DekkrixX/Data-Monitoring-Football-Fan/README.md

# Data-Monitoring-Football-Fan

Installation des dépendances `make install`.

Construction des images Docker `make build`.

Flash des cartes ESP32 utilisez le script flash.sh `bash Scripts/flash.sh <cible>`.

Lancement des serveurs `make run`.

---











---

## Description du projet

Le projet de monitoring pour supporters de football est la réalisation d'une collaboration entre le Lab-STICC (le centre de recherche de Lorient) et le FCL (le Football Club de Lorient). L'objectif de ce projet est de développer une solution IoT performante, économique et à gestion locale des données pour analyser les données des supporters pendant les matchs de football. Les données collectées seront utilisées pour réaliser une vidéo promotionnelle valorisant le club, la ville et le laboratoire de recherche de Lorient. Le projet est réalisé par des étudiants du Master Systèmes Embarqués - Systèmes Intégrés à Lorient sous la supervision de deux ingénieurs du Lab-STICC.

## Fonctionnalitées du projet

- Collect de la fréquence cardiaque
- Collect de données de mouvement
- Collect de données acoustique
- Collect d'information système
- Tracking d'objet
- Affichage des statistiques des données des utilisateurs
- Affichage des statistiques des données des tribunes du stade
- Gestion des évènements du match en direct
