DekkrixX/Data-Monitoring-Football-Fan/Resources/Images/schema_noeud_LoRa.png

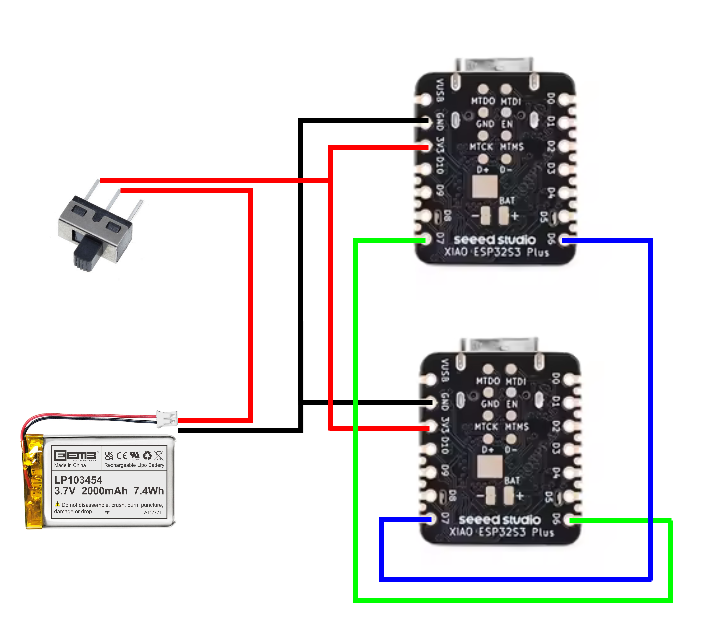
Resources/Images/schema_noeud_LoRa.png
