DekkrixX/Data-Monitoring-Football-Fan/Documentation/test.md

# Tests

# Lancer les tests de simulations

Pour lancer les tests de simulations il faut taper `make test` à la racine du projet. Cela va lancer un script python en tâche de fond, qui envoi des données toutes les secondes sur le brocker MQTT.

# Tests de portée LoRa en ligne de vue

Test avec le firmware Meshtastic et le paramètre LONG_FAST distance de 800 mètres sans perte de paquets.
