DekkrixX/Data-Monitoring-Football-Fan/(commit log)

2026-03-02 Réécriture du code (optimisation, extensibilité, centralisation des paramètres) + documentation complète
2026-03-03 Gestion du duty cycle + bufferisation des données
2026-03-03 Gestion de message d'information système
2026-03-03 Correction duty cycle + info capteur
    [PolarH10.cpp, setting.hpp]
2026-03-03 Fix bug buffer UART inversé
    [UARTManager.cpp, UARTManager.hpp]
2026-03-03 Ajout de la doc du commit précédant
2026-03-03 Mise à jour de la Documentation
2026-03-04 Tests de distance de portée
2026-03-05 Chiffrage des variables d'environnement
2026-03-06 Ajout d'un système de log pour le server et le device
    [partitions.csv]
2026-03-06 Ajout d'un script de chiffrement/déchiffrement
2026-04-08 Ajout des formats de données et des montages des capteurs dans la documentation
2026-04-08 Modification du système de log pour séparer les logs de debug et les logs de données
2026-04-09 Integration du capteur MinIMU-9 v6 dans les données serveur
2026-04-09 Ajout des link card de monitoring des tribunes
2026-04-10 Intégration des données du capteur MinIMU-9 v6 au serveur + visualisation
2026-04-10 Modification du format d'envoi des données du capteur MinIMU-9 v6
2026-04-10 Ajout de la prise en compte du delais d'acquisition des capteurs dans le timestamp des données
2026-04-10 Initialisation de la structure du capteur INMP441
2026-04-10 Ajout du type de données acoustique
2026-04-14 Ajout de la structure de controle via l'interface web
2026-04-14 Correction de l'installation automatique (PC vierge)
2026-04-14 Interprétation des données brutes
2026-04-14 Optimisation des envois de message via LoRa
2026-04-15 Gestion des dépendances par Docker
2026-04-15 Ajout de test de simulation des données
2026-04-16 Modification des scripts pour la compatibilité avec Docker
2026-04-16 Uniformisation du code et des commantaires
2026-04-16 Mise à jour de la doc
2026-04-17 Structure de l'interface de contrôle d'évènement + correction test complet (sans compatibilité entre les données device et server)
    [setting.hpp]
2026-04-17 Changement d'encodage du type de données qui circule via LoRa
2026-04-20 Changement de format d'envoie de données du capteur MinIMU-9 v6 (norme du vecteur accélération)
2026-04-23 Changement du visuel de l'interface et ajout de la partie contrôle d'évènements
2026-04-23 Gestion de la création d'une configuration de contrôle d'évènements
2026-04-24 Gestion des informations d'avant match et des évènements en temps réel
2026-04-24 Ajout de champs général de modification d'évènement
2026-04-27 Ajout des données capteurs dans InfluxDB
2026-04-27 Ajout des données d'évènements à la base de données PostgreSQL
2026-04-28 Ajout de la modification des informations d'évènement
2026-04-29 Gestion complète des données d'évènements
2026-04-29 Ajout de la minute de jeu dans le nom des évènements
2026-04-30 Gestion de la cohérance entre le timestamp et la minute de jeu d'un évènement
2026-04-30 Changement de l'ordre de la liste des évènements pour garder la logique chronologique
2026-05-04 Ajout de la clé GPG du labsticc + correction d'ajout et suppression de clé
2026-05-04 Fix erreur nom de fichier
2026-05-06 Modification des tests de distance + vérification de la configuration Meshtastic
2026-05-11 Modification erreur de syntaxe
2026-05-12 Ajout de MeshCore sur la partie serveur
2026-05-13 Fix problème de crash du code du capteur INMP441
2026-05-13 Ajout des adresses MAC
2026-05-13 Ajout de solution de potentiel problème
2026-05-18 Ajout de gestion de la LED de la carte + Fix bug lectrue des logs sur UART
    [main.cpp, setting.hpp]
2026-05-18 Ajout couleur LED en cas d'erreur et inclusion du code des capteurs en fonction du capteur configuré
2026-05-18 Mise à jour des schémas
2026-05-18 Fix potentiel fuite mémoire si plusieurs instance de class
    [MinIMU-9_v6.cpp, PolarH10.cpp, UARTManager.cpp, main.cpp, setting.hpp]
2026-05-18 Modification LEDManager pour faire clignoter la LED
2026-05-19 Ajout page de log d'information système des capteurs
2026-05-19 Formatage des pages web (page fixe sans scroll)
2026-05-19 Changement nombre de logger
2026-05-19 Modification du test de distance
    [config.txt, partitions.csv]
2026-05-19 Ajout de la suppression des conteneurs de test
2026-05-19 Suppression des images docker au clear
2026-05-22 Ajout de la gestion de tracker coté serveur et client
2026-05-22 Ajout de test de simulation pour les trackers
2026-05-26 Ajout du chemin de tracer des trackers
2026-05-26 Modification test tracking, ajout d'un léger dépassement de zone
2026-05-26 Ajout de l'utilisation des cartes UWB Qorvo
2026-05-26 Ajout de la procédure de flash des cartes UWB
2026-05-26 Ajout de la description de la carte UWB
2026-05-27 Ajout de la récupération des communications des cartes UWB et calcul de la position
2026-05-29 Correction orthographe
    [config.txt]
2026-06-01 Modification bug affichage + ajout d'envoie de messages de données
    [main.cpp, run.py, setting.hpp]
2026-06-01 Ajout de rapport et de controle du snr et rssi
2026-06-10 Support de test de plusieurs émetteur en simultané
2026-06-15 Ajout de la clé Meshtastic dans le .env
2026-06-15 Correcton erreur callback que paquet incomplet
    [run.py]
